IJeffray/IanS_ide_podule-8bit/PCB/README.md

# ide podule 8bit

These are the KiCad (version 8) files for the 8-bit ide podule.
