IJeffray/IanS_ide_podule-8bit/PCB/Altium/ide_podule-8bit_horiz_backplate.STEP

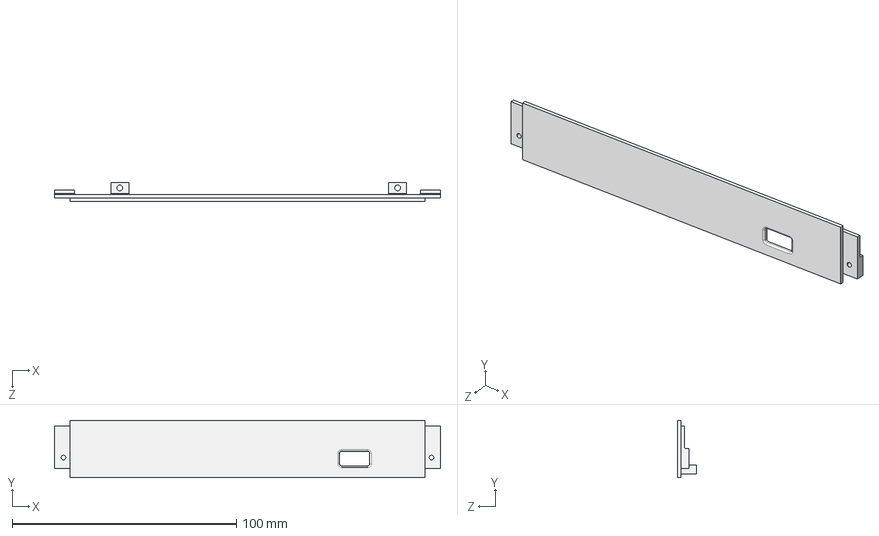
[picture p2: CAD file, 2026-10-07]
PCB/Altium/ide_podule-8bit_horiz_backplate.STEP
172.0 x 25.6 x 8.60 mm
