IJeffray/IanS_ide_podule-8bit/(list of files, cad)

Other CAD files:
PCB/Altium/ide_podule-8bit_horiz_backplate.SLDASM
PCB/Altium/ide_podule-8bit_horiz_backplate.SLDPRT
