IJeffray/IanS_ide_podule-8bit/Schematic.pdf

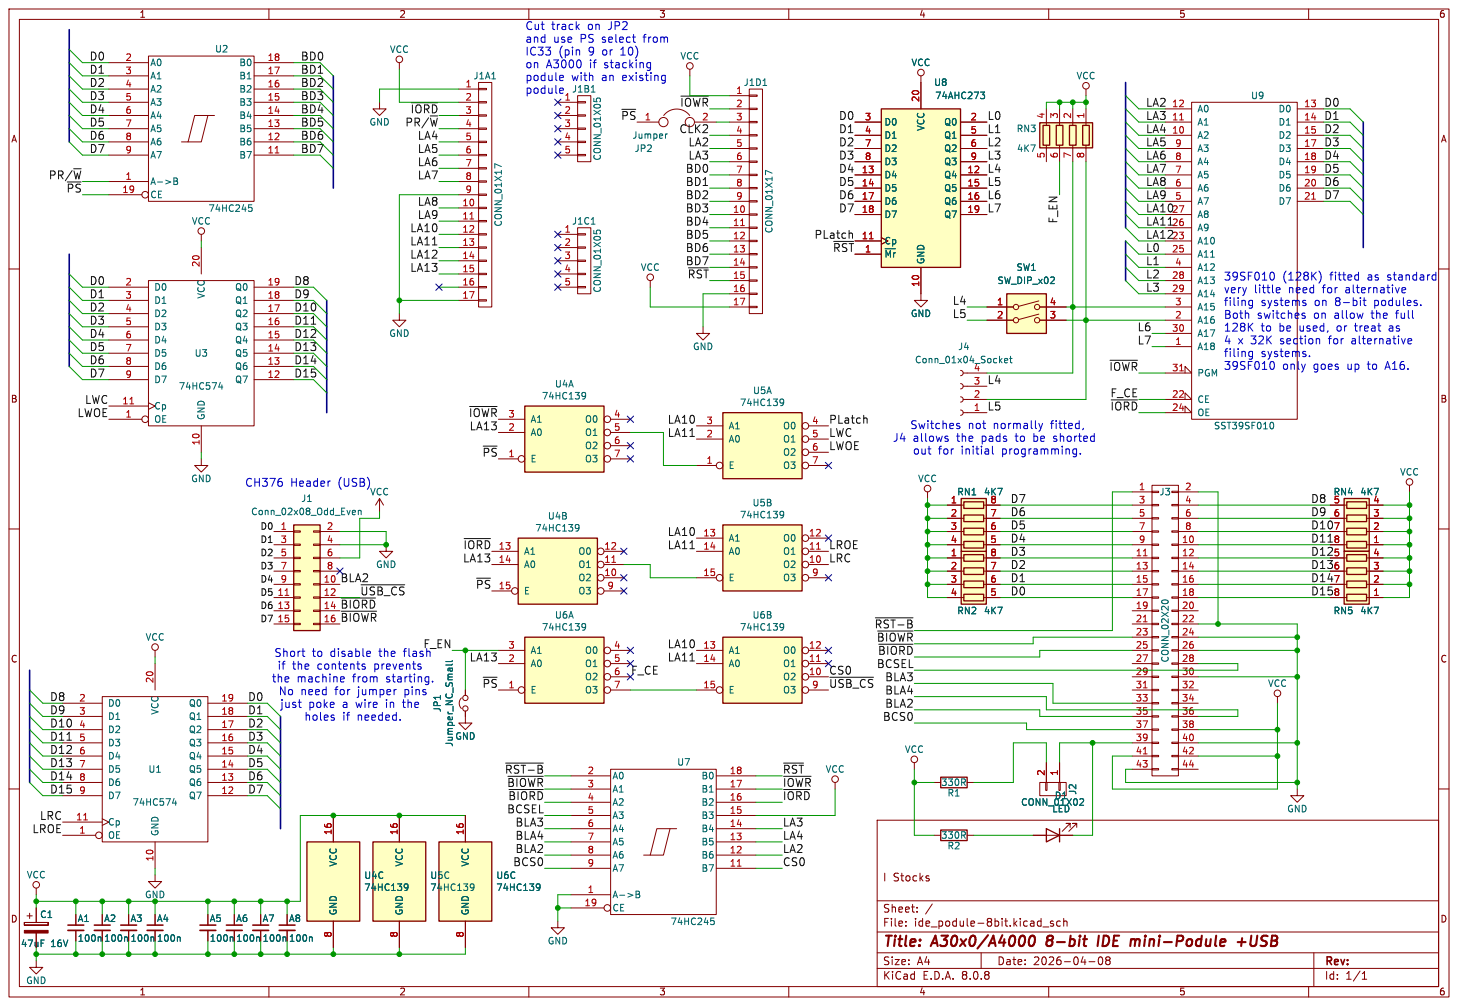
[picture p3: page 1]

39SF010 only goes up to A16. Cut track on JP2
and use PS select from
IC33 (pin 9 or 10) on A3000 if stacking
4/5 J1B1 CONN_01X05

podule with an existing

39SF010 (128K) fitted as standard
very little need for alternative

Short to disable the flash
the machine from starting. No need for jumper pins

just poke a wire in the
holes if needed.
