IJeffray/IanS_ide_podule-8bit/(list of files, drawings)

Other design files:
PCB/Altium/ide_podule-8bit.PcbDoc
PCB/Altium/ide_podule-8bit.PcbLib
PCB/Altium/ide_podule-8bit.PrjPcb
PCB/Altium/ide_podule-8bit.SchDoc
PCB/Altium/ide_podule-8bit.SchLib
PCB/Altium/ide_podule-8bit_horiz.PcbDoc
