IJeffray/IanS_ide_podule-8bit/PCB/ide_podule-8bit.kicad_pcb

## KiCad design PCB/ide_podule-8bit.kicad_pcb (2026-04-19)

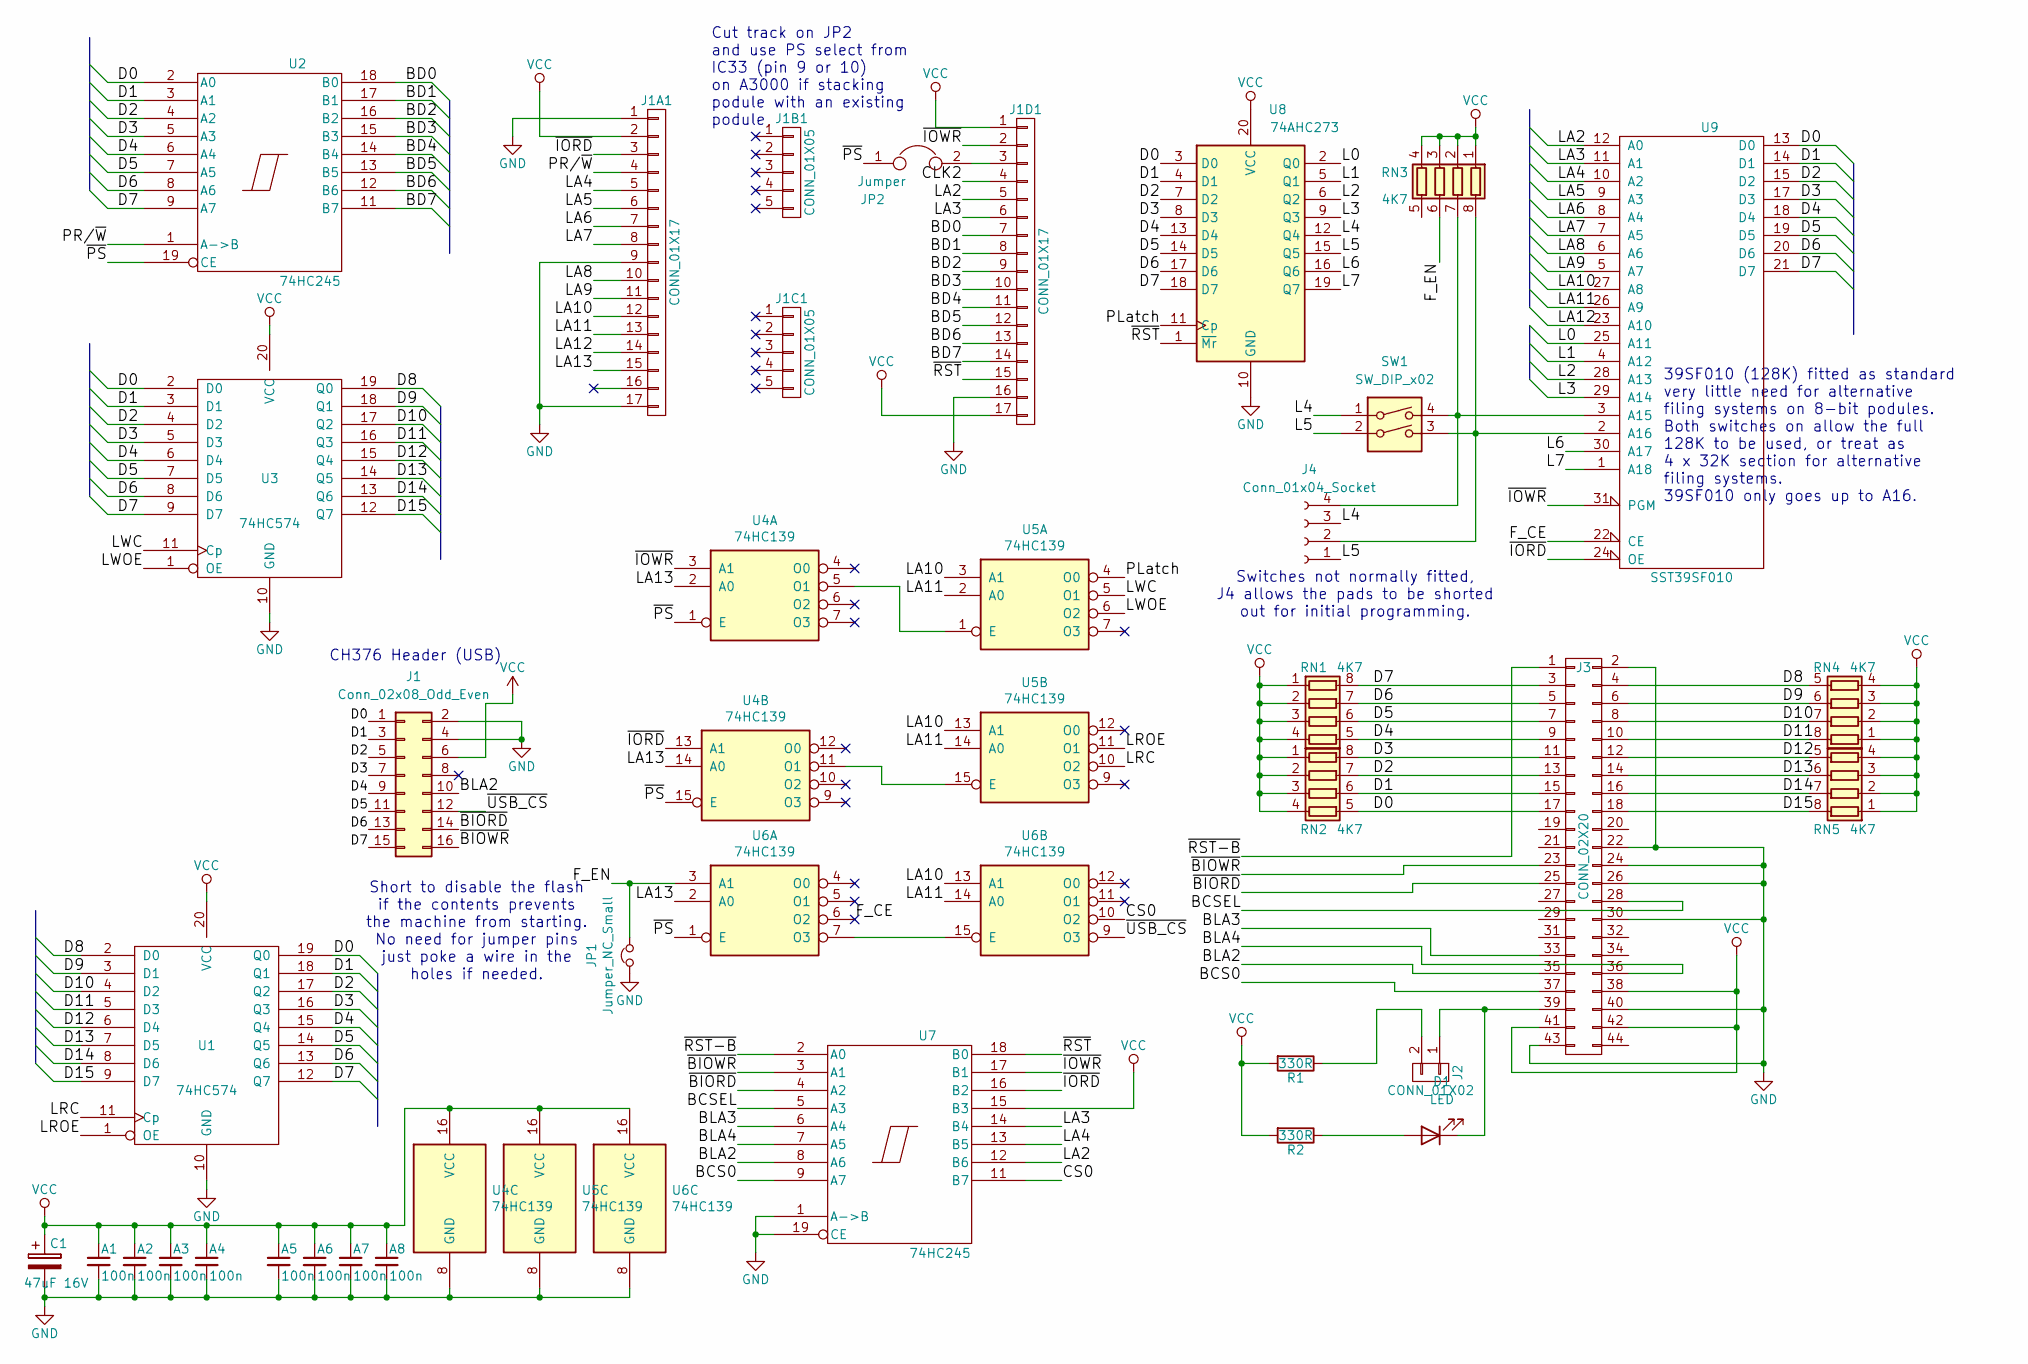
[picture p4: schematic ide_podule-8bit.kicad_sch, A30x0/A4000 8-bit IDE mini-Podule +USB]

Parts:
A1, A2, A3, A4, A5, A6, A7, A8: 100n; C_1206_3216Metric_Pad1.33x1.80mm_HandSolder
C1: 47uF 16V; CP_EIA-6032-20_AVX-F_Pad2.25x2.35mm_HandSolder
D1: LED; LED_1206_3216Metric_Pad1.42x1.75mm_HandSolder
J1: Conn_02x08_Odd_Even; CH376-mod
J1A1, J1D1: CONN_01X17; PinHeader_1x17_P2.54mm_Vertical
J1B1, J1C1: CONN_01X05; PinHeader_1x05_P2.54mm_Vertical
J2: CONN_01X02; PinHeader_1x02_P2.54mm_Vertical
J3: CONN_02X20; PinHeader_2x22_P2.00mm_Vertical
J4: Conn_01x04_Socket; 4 way edge
JP1: Jumper_NC_Small; PinHeader_1x02
JP2: Jumper; PinHeader_1x02-linked
R1, R2: 330R; R_1206_3216Metric_Pad1.30x1.75mm_HandSolder
RN1, RN2, RN3, RN4, RN5: 4K7; R_Array_Concave_4x0603
SW1: SW_DIP_x02; DIP-4_W7.62mm_Socket
U1, U3: 74HC574; SOIC-20W_7.5x12.8mm_P1.27mm
U2, U7: 74HC245; SOIC-20W_7.5x12.8mm_P1.27mm
U4, U5, U6: 74HC139; SOIC-16_3.9x9.9mm_P1.27mm
U8: 74AHC273; SOIC-20W_7.5x12.8mm_P1.27mm
U9: SST39SF010; PLCC-32_11.4x14.0mm_P1.27mm

Connections:
/BCS0: J3.37, U7.9 (A7)
/BCSEL: J3.28, U7.5 (A3)
/BD0: J1D1.7, U2.18 (B0)
/BD1: J1D1.8, U2.17 (B1)
/BD2: J1D1.9, U2.16 (B2)
/BD3: J1D1.10, U2.15 (B3)
/BD4: J1D1.11, U2.14 (B4)
/BD5: J1D1.12, U2.13 (B5)
/BD6: J1D1.13, U2.12 (B6)
/BD7: J1D1.14, U2.11 (B7)
/BLA2: J1.10, J3.35, U7.8 (A6)
/BLA3: J3.33, U7.6 (A4)
/BLA4: J3.36, U7.7 (A5)
/CLK2: J1D1.4
/CS0: U6.10 (O2), U7.11 (B7)
/D0: J1.1, J3.17, RN2.5 (R4.2), U1.19 (Q0), U2.2 (A0), U3.2 (D0), U8.3 (D0), U9.13 (D0)
/D1: J1.3, J3.15, RN2.6 (R3.2), U1.18 (Q1), U2.3 (A1), U3.3 (D1), U8.4 (D1), U9.14 (D1)
/D2: J1.5, J3.13, RN2.7 (R2.2), U1.17 (Q2), U2.4 (A2), U3.4 (D2), U8.7 (D2), U9.15 (D2)
/D3: J1.7, J3.11, RN2.8 (R1.2), U1.16 (Q3), U2.5 (A3), U3.5 (D3), U8.8 (D3), U9.17 (D3)
/D4: J1.9, J3.9, RN1.5 (R4.2), U1.15 (Q4), U2.6 (A4), U3.6 (D4), U8.13 (D4), U9.18 (D4)
/D5: J1.11, J3.7, RN1.6 (R3.2), U1.14 (Q5), U2.7 (A5), U3.7 (D5), U8.14 (D5), U9.19 (D5)
/D6: J1.13, J3.5, RN1.7 (R2.2), U1.13 (Q6), U2.8 (A6), U3.8 (D6), U8.17 (D6), U9.20 (D6)
/D7: J1.15, J3.3, RN1.8 (R1.2), U1.12 (Q7), U2.9 (A7), U3.9 (D7), U8.18 (D7), U9.21 (D7)
/D8: J3.4, RN4.5 (R4.2), U1.2 (D0), U3.19 (Q0)
/D9: J3.6, RN4.6 (R3.2), U1.3 (D1), U3.18 (Q1)
/D10: J3.8, RN4.7 (R2.2), U1.4 (D2), U3.17 (Q2)
/D11: J3.10, RN4.8 (R1.2), U1.5 (D3), U3.16 (Q3)
/D12: J3.12, RN5.5 (R4.2), U1.6 (D4), U3.15 (Q4)
/D13: J3.14, RN5.6 (R3.2), U1.7 (D5), U3.14 (Q5)
/D14: J3.16, RN5.7 (R2.2), U1.8 (D6), U3.13 (Q6)
/D15: J3.18, RN5.8 (R1.2), U1.9 (D7), U3.12 (Q7)
/F_CE: U6.6 (O2), U9.22 (CE)
/F_EN: JP1.2, RN3.6 (R3.2), U6.3 (A1)
/L0: U8.2 (Q0), U9.25 (A11)
/L1: U8.5 (Q1), U9.4 (A12)
/L2: U8.6 (Q2), U9.28 (A13)
/L3: U8.9 (Q3), U9.29 (A14)
/L4: J4.3, SW1.1, U8.12 (Q4)
/L5: J4.1, SW1.2, U8.15 (Q5)
/L6: U8.16 (Q6), U9.30 (A17)
/L7: U8.19 (Q7), U9.1 (A18)
/LA2: J1D1.5, U7.12 (B6), U9.12 (A0)
/LA3: J1D1.6, U7.14 (B4), U9.11 (A1)
/LA4: J1A1.5, U7.13 (B5), U9.10 (A2)
/LA5: J1A1.6, U9.9 (A3)
/LA6: J1A1.7, U9.8 (A4)
/LA7: J1A1.8, U9.7 (A5)
/LA8: J1A1.10, U9.6 (A6)
/LA9: J1A1.11, U9.5 (A7)
/LA10: J1A1.12, U5.3 (A1), U5.13 (A1), U6.13 (A1), U9.27 (A8)
/LA11: J1A1.13, U5.2 (A0), U5.14 (A0), U6.14 (A0), U9.26 (A9)
/LA12: J1A1.14, U9.23 (A10)
/LA13: J1A1.15, U4.2 (A0), U4.14 (A0), U6.2 (A0)
/LRC: U1.11 (Cp), U5.10 (O2)
/LROE: U1.1 (OE), U5.11 (O1)
/LWC: U3.11 (Cp), U5.5 (O1)
/LWOE: U3.1 (OE), U5.6 (O2)
/PLatch: U5.4 (O0), U8.11 (Cp)
/PR/~W: J1A1.4, U2.1 (A->B)
/~BIORD: J1.14, J3.25, U7.4 (A2)
/~BIOWR: J1.16, J3.23, U7.3 (A1)
/~IORD: J1A1.3, U4.13 (A1), U7.16 (B2), U9.24 (OE)
/~IOWR: J1D1.2, U4.3 (A1), U7.17 (B1), U9.31 (PGM)
/~PS: JP2.1, U2.19 (CE), U4.1 (E), U4.15 (E), U6.1 (E)
/~RST-B: J3.1, U7.2 (A0)
/~RST: J1D1.15, U7.18 (B0), U8.1 (~Mr)
/~USB_CS: J1.12, U6.9 (O3)
GND: A1.2, A2.2, A3.2, A4.2, A5.2, A6.2, A7.2, A8.2, C1.2, J1.2, J1.4, J1A1.1, J1A1.9, J1A1.17, J1D1.16, J3.2, J3.22, J3.24, J3.26, J3.30, J3.40, J3.43, JP1.1, U1.10 (GND), U2.10 (GND), U3.10 (GND), U4.8 (GND), U5.8 (GND), U6.8 (GND), U7.1 (A->B), U7.10 (GND), U7.19 (CE), U8.10 (GND), U9.16 (GND)
unnamed: D1.2 (A), R2.1
unnamed: D1.1 (K), J2.1, J3.39
unnamed: J1D1.3, JP2.2
unnamed: J2.2, R1.1
unnamed: J4.2, RN3.8 (R1.2), SW1.3, U9.2 (A16)
unnamed: J4.4, RN3.7 (R2.2), SW1.4, U9.3 (A15)
unnamed: U4.5 (O1), U5.1 (E)
unnamed: U4.11 (O1), U5.15 (E)
unnamed: U6.7 (O3), U6.15 (E)
VCC: A1.1, A2.1, A3.1, A4.1, A5.1, A6.1, A7.1, A8.1, C1.1, J1.6, J1A1.2, J1D1.1, J1D1.17, J3.38, J3.41, J3.42, R1.2, R2.2, RN1.1 (R1.1), RN1.2 (R2.1), RN1.3 (R3.1), RN1.4 (R4.1), RN2.1 (R1.1), RN2.2 (R2.1), RN2.3 (R3.1), RN2.4 (R4.1), RN3.1 (R1.1), RN3.2 (R2.1), RN3.3 (R3.1), RN3.4 (R4.1), RN4.1 (R1.1), RN4.2 (R2.1), RN4.3 (R3.1), RN4.4 (R4.1), RN5.1 (R1.1), RN5.2 (R2.1), RN5.3 (R3.1), RN5.4 (R4.1), U1.20 (VCC), U2.20 (VCC), U3.20 (VCC), U4.16 (VCC), U5.16 (VCC), U6.16 (VCC), U7.15 (B3), U7.20 (VCC), U8.20 (VCC), U9.32 (VCC)

Notes on the sheet:
Switches not normally fitted, J4 allows the pads to be shorted out for initial programming.
39SF010 (128K) fitted as standard very little need for alternative filing systems on 8-bit podules. Both switches on allow the full 128K to be used, or treat as 4 x 32K section for alternative filing systems. 39SF010 only goes up to A16.
Cut track on JP2 and use PS select from IC33 (pin 9 or 10) on A3000 if stacking podule with an existing podule
CH376 Header (USB)
Short to disable the flash if the contents prevents the machine from starting. No need for jumper pins just poke a wire in the holes if needed.

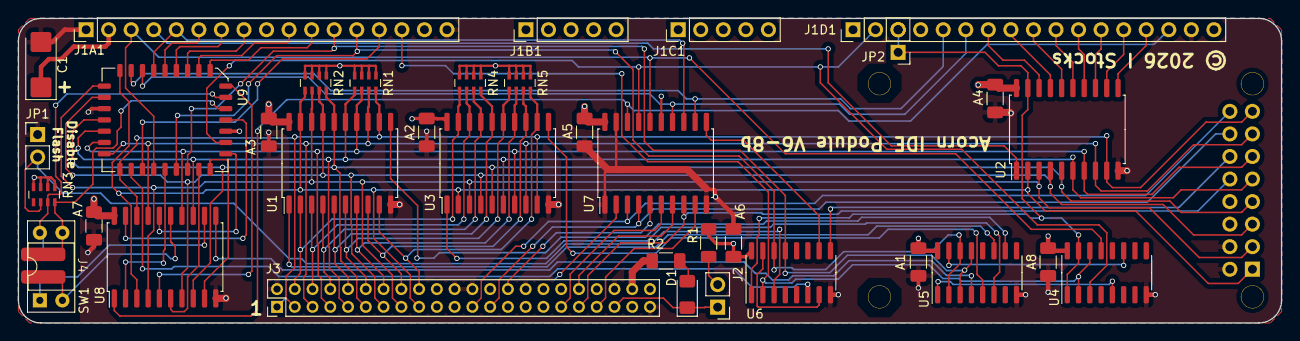
[picture p5: board ide_podule-8bit.kicad_pcb from above]

Board: 4 copper layers, 142.2 x 34.3 mm, 37 parts (1 on the bottom side), 77 nets.
