IJeffray/IanS_ide_podule-8bit/(commit log)

2026-04-19 initial version
    [ide_podule-8bit.kicad_pcb, ide_podule-8bit.kicad_sch]
2026-09-11 Created 'traditional' horizontal version of this podule again, but with the USB socket out the back. 3D-printable backplate model included.
    [ide_podule-8bit.PcbDoc, ide_podule-8bit.PrjPcb, ide_podule-8bit.SchDoc, ide_podule-8bit_horiz.PcbDoc, ide_podule-8bit_horiz_backplate.SLDPRT, ide_podule-8bit_horiz_backplate.STEP]
2026-09-14 Larger pads for flash (suit SMT socket). Missed GND pins on three ICs (not in imported schematic). Tweaked routing. Tented vias. 0805 passives.
    [ide_podule-8bit.PrjPcb, ide_podule-8bit.SchDoc, ide_podule-8bit_horiz.PcbDoc]
2026-10-07 Tweaks including backplate.
    [ide_podule-8bit.PcbLib, ide_podule-8bit.SchLib, ide_podule-8bit_horiz.PcbDoc, ide_podule-8bit_horiz_backplate.SLDASM, ide_podule-8bit_horiz_backplate.SLDPRT, ide_podule-8bit_horiz_backplate.STEP]
