IJeffray/IanS_ide_podule-8bit/(notices)

Notices in the files:
PCB/ide_podule-8bit.kicad_pcb:
© 2026 I Stocks
